pbh2/ELEC327-Final-Project/IMG_5187.jpg

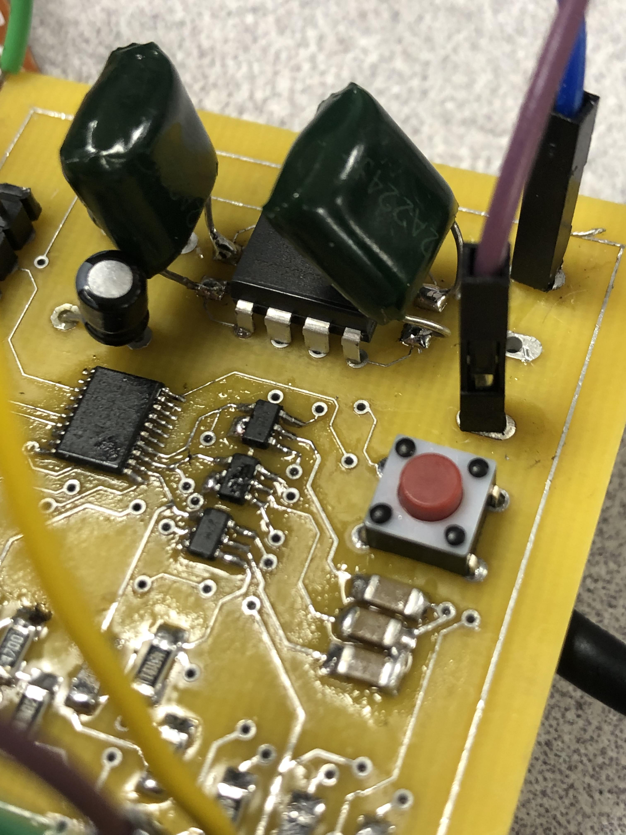
IMG_5187.jpg
