pbh2/ELEC327-Final-Project/IMG_5186.jpg

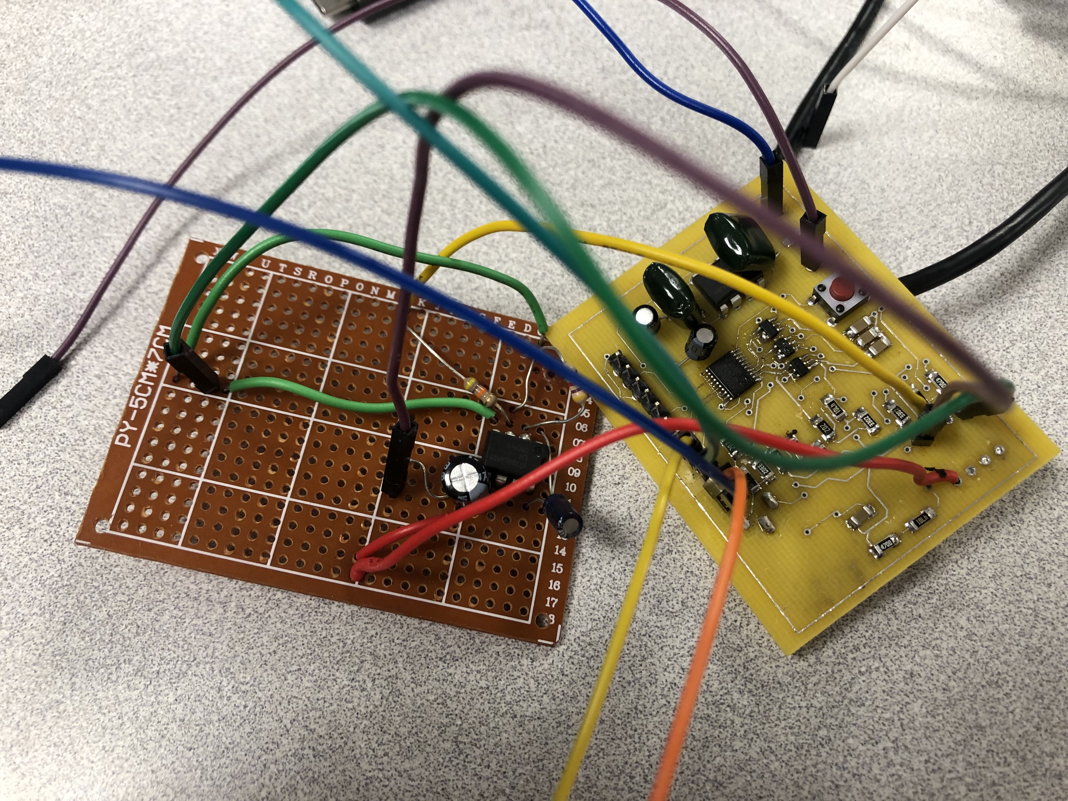
IMG_5186.jpg
