pbh2/ELEC327-Final-Project/README.md

# ELEC327-Final-Project
By John Reko, Peter Humphreys, and Sean Hamilton
