pbh2/ELEC327-Final-Project/Unused/README

These code files were designed for using SPI to control a ws2812b LED strip. Unfortunately we were unable to use this.
