pbh2/ELEC327-Final-Project/IMG_5185.jpg

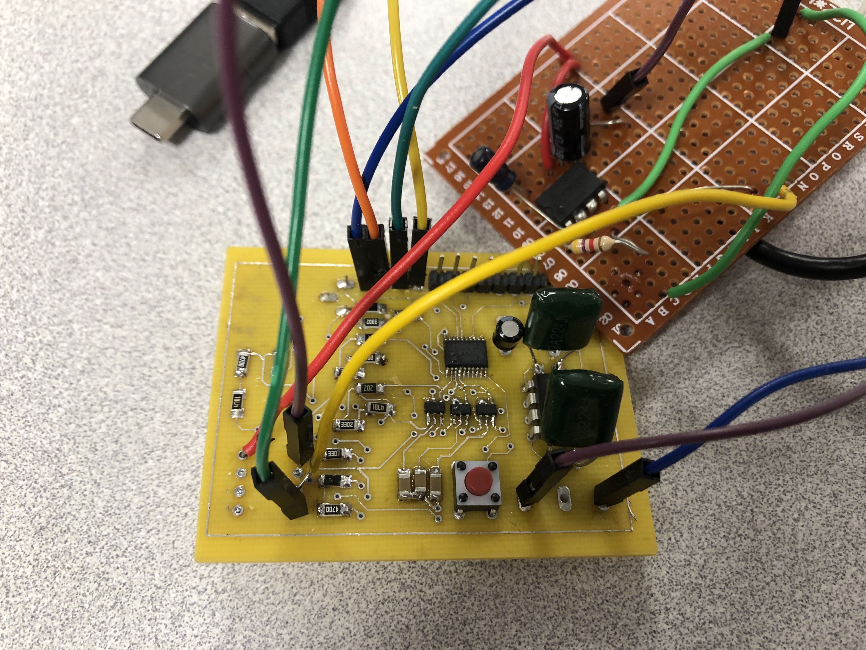
IMG_5185.jpg
