pbh2/ELEC327-Final-Project/ELEC327_V4.brd

## EAGLE design ELEC327_V4.brd (2023-05-03)

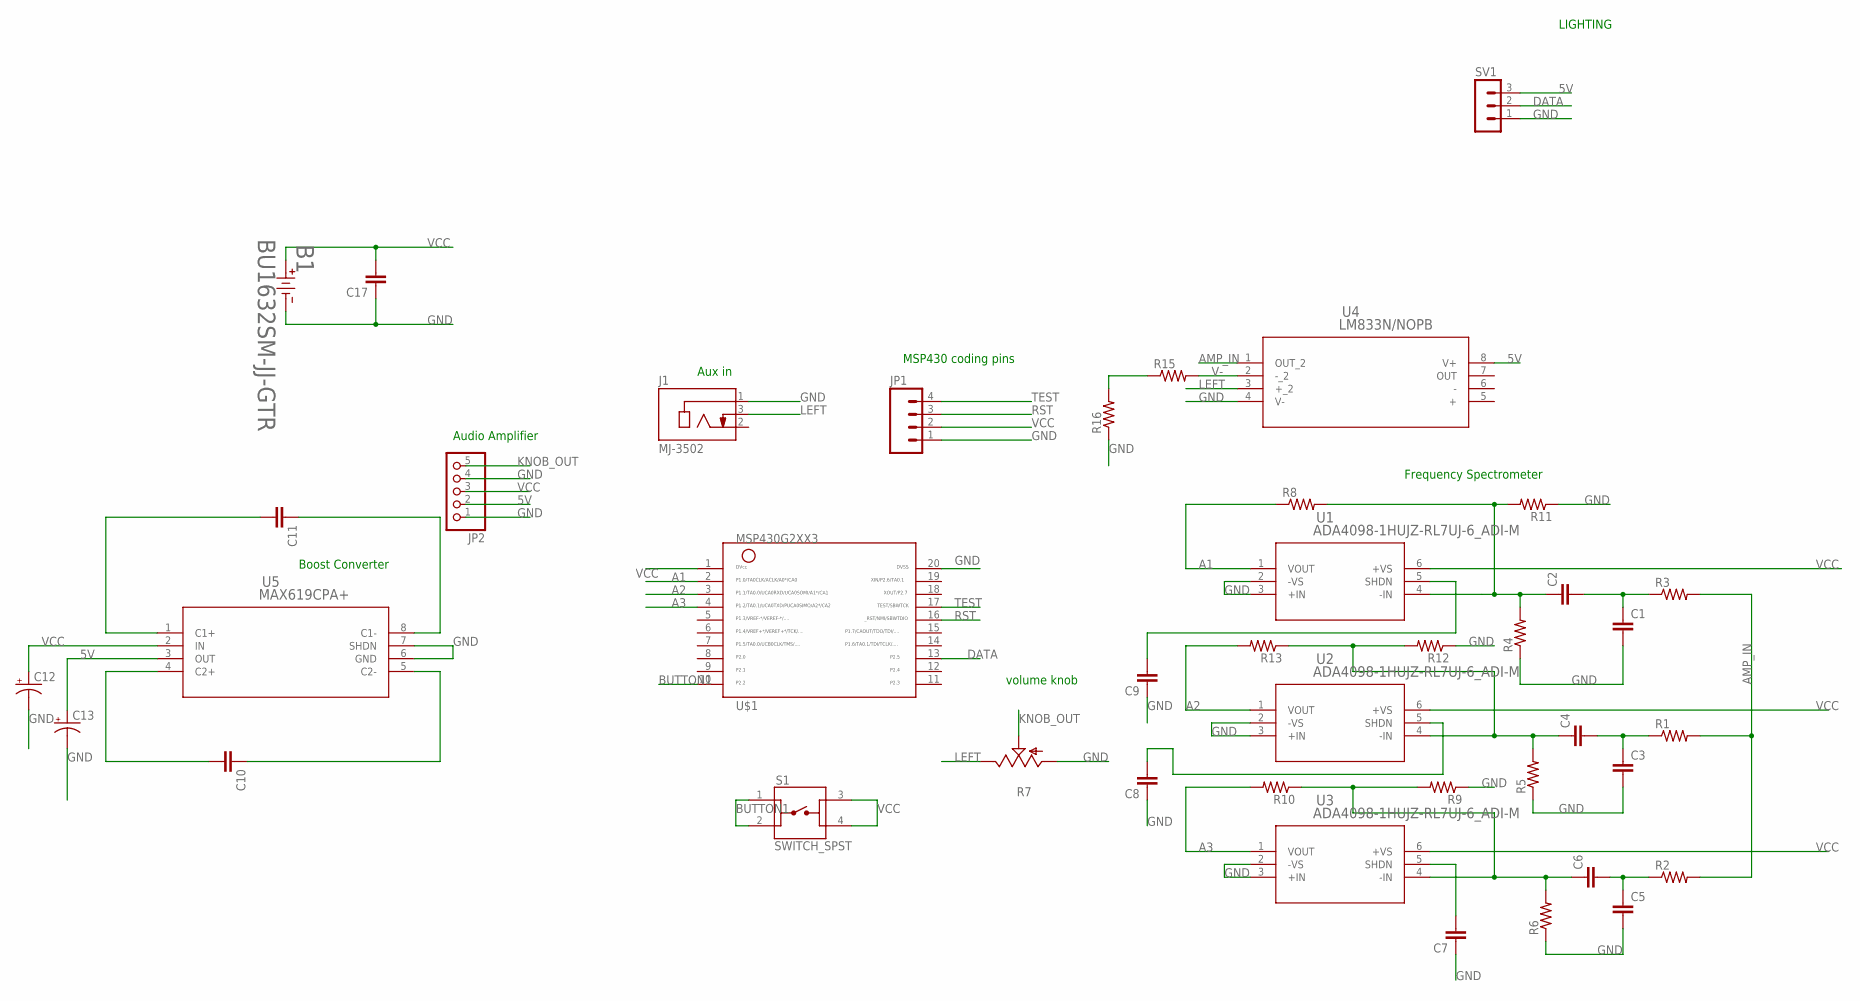
[picture p12: schematic ELEC327_V4.sch]

Parts:
B1: BU1632SM-JJ-GTR; BU1632SM-JJ-GTR_MPD
C1, C2, C3, C4, C5, C6, C7, C8, C9, C10, C11, C17: C-EUC1206; C1206
C12, C13: CPOL-USE5-6; E5-6
J1: MJ-3502; CUI_MJ-3502
JP1: HEADER_1X04LOCK; 1X04_LOCK
JP2: PINHD-1X55X2MM; 1_05X2MM
R1, R2, R3, R4, R5, R6, R8, R9, R10, R11, R12, R13, R15, R16: R-US_R1206; R1206
R7: TRIM_US-B25X; B25X
S1: SWITCH_SPST; SW_1825910-7
SV1: MA03-1
U1, U2, U3: ADA4098-1HUJZ-RL7UJ-6_ADI-M; UJ-6_ADI-M
U4: LM833N/NOPB; N08E_TEX
U5: MAX619CPA+; 21-0043D_8_MXM
U$1: MSP430G2XX3TSSOP; PW20

Connections:
5V: C13.+, JP2.2, SV1.3, U4.8 (V+), U5.3 (OUT)
A1: R8.1, U1.1 (VOUT), U$1.2
A2: R13.2, U2.1 (VOUT), U$1.3
A3: R10.2, U3.1 (VOUT), U$1.4
AMP_IN: R1.2, R2.2, R3.2, U4.1 (OUT_2)
BUTTON1: S1.1, S1.2, U$1.10
DATA: SV1.2, U$1.13
GND: B1.2, C1.2, C3.2, C5.2, C7.1, C8.1, C9.1, C12.-, C13.-, C17.1, J1.1, JP1.1, JP2.1, JP2.4, R4.1, R5.1, R6.1, R7.A, R9.1, R11.1, R12.1, R16.1, SV1.1, U1.2 (-VS), U1.3 (+IN), U2.2 (-VS), U2.3 (+IN), U3.2 (-VS), U3.3 (+IN), U4.4 (V-), U5.6 (GND), U5.7 (SHDN), U$1.20
KNOB_OUT: JP2.5, R7.S
LEFT: J1.3, R7.E, U4.3 (+_2)
unnamed: C2.1, R4.2, R8.2, R11.2, U1.4 (-IN)
unnamed: C1.1, C2.2, R3.1
unnamed: C3.1, C4.2, R1.1
unnamed: C5.1, C6.2, R2.1
unnamed: C4.1, R5.2, R12.2, R13.1, U2.4 (-IN)
unnamed: C7.2, U3.5 (SHDN)
unnamed: C6.1, R6.2, R9.2, R10.1, U3.4 (-IN)
unnamed: C8.2, U2.5 (SHDN)
unnamed: C9.2, U1.5 (SHDN)
unnamed: C10.2, U5.4 (C2+)
unnamed: C10.1, U5.5 (C2-)
unnamed: C11.2, U5.1 (C1+)
unnamed: C11.1, U5.8 (C1-)
unnamed: R15.1, R16.2
RST: JP1.3, U$1.16
TEST: JP1.4, U$1.17
V-: R15.2, U4.2 (-_2)
VCC: B1.1, C12.+, C17.2, JP1.2, JP2.3, S1.3, S1.4, U1.6 (+VS), U2.6 (+VS), U3.6 (+VS), U5.2 (IN), U$1.1

Notes on the sheet:
LIGHTING
Audio Amplifier
Boost Converter
Aux in
MSP430 coding pins
volume knob
Frequency Spectrometer

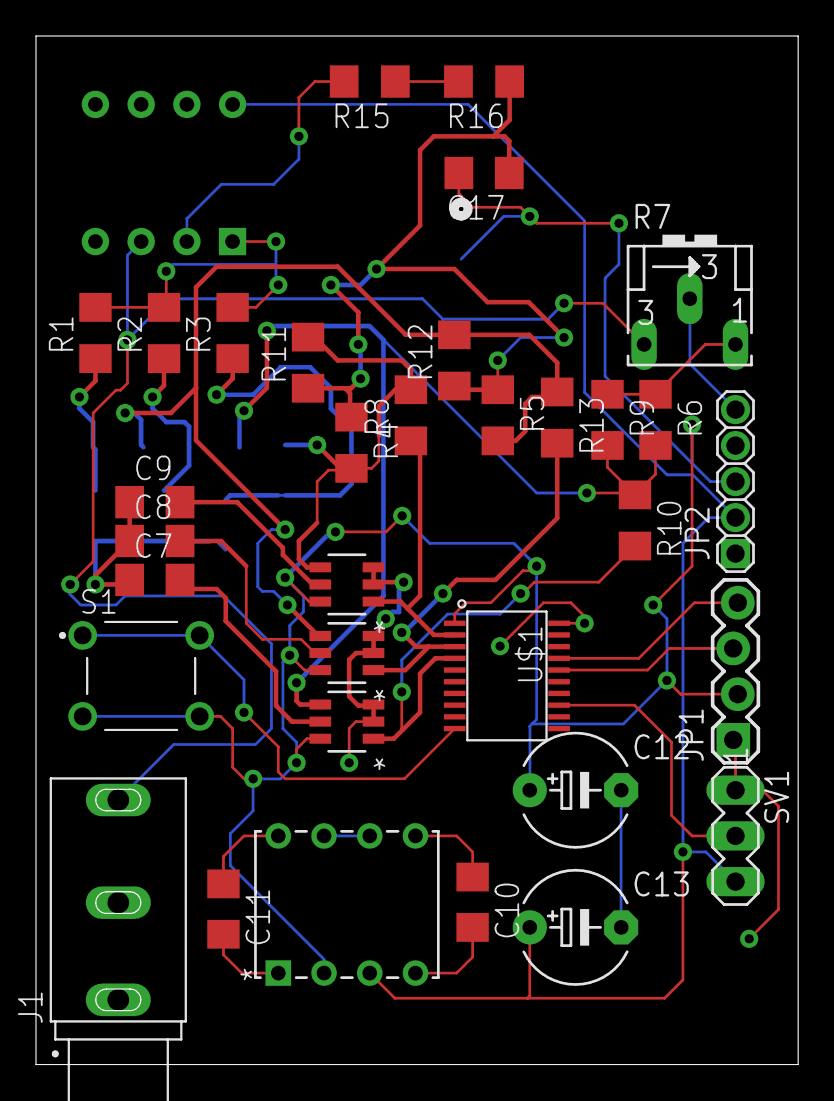
[picture p13: board ELEC327_V4.brd from above]

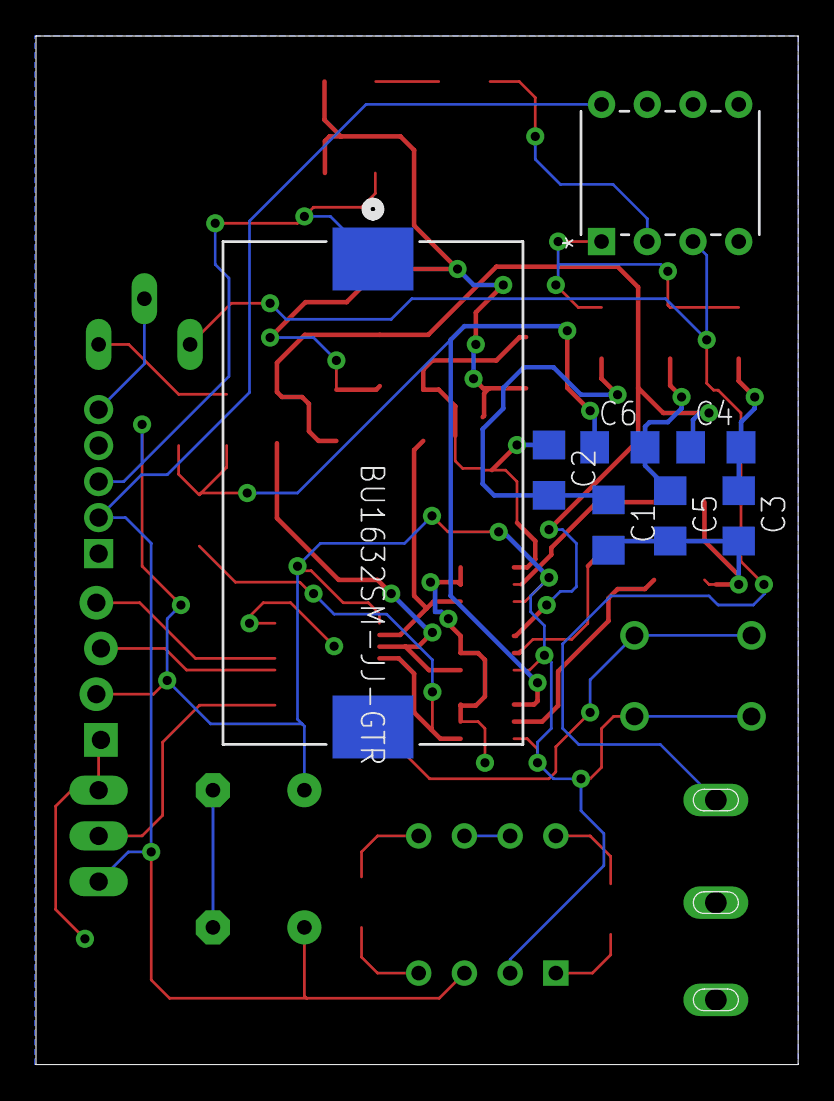
[picture p14: board ELEC327_V4.brd from below]

Board: 2 copper layers, 42.3 x 57.1 mm, 41 parts (8 on the bottom side), 28 nets.
