pbh2/ELEC327-Final-Project/(notices)

Notices in the files:
parts and their libraries:
ELEC327: COPYRIGHT: Copyright (C) 2023 Ultra Librarian. All rights reserved.
